JackToaster/SynthPass/hardware/SynthPass.kicad_pcb

## KiCad design hardware/SynthPass.kicad_pcb (2026-10-18)

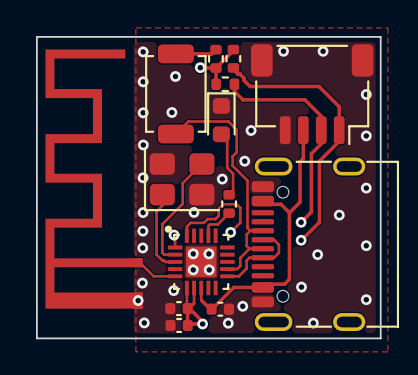
[picture p1: board SynthPass.kicad_pcb from above]

Board: 4 copper layers, 19.1 x 16.8 mm, 14 parts (0 on the bottom side), 13 nets.

Parts:
AE1: PCB Antenna; Texas_SWRA117D_2.4GHz_Right
C1, C3: 10u; C_0402_1005Metric
C4: 0.1u; C_0402_1005Metric
D1: LED_Small; LED_0603_1608Metric
J1: SM04B-SRSS-TB; JST_SH_SM04B-SRSS-TB_1x04-1MP_P1.00mm_Horizontal
P1: USB_C_Plug_USB2.0; USB_C_Receptacle_G-Switch_GT-USB-7010ASV
R1, R2, R3, R4: 5.1k; R_0402_1005Metric
SW1: SW_Push; SW_SPST_TS-1088-xR020
U2: CH572D
Y2: 32MHz; Crystal_SMD_3225-4Pin_3.2x2.5mm

Connections:
+3V3: C3.1, C4.1, R1.2, R3.2, R4.2, U2.6 (VDD33), U2.7 (VIO33)
GND: AE1.2 (PCB_Trace), C1.2, C3.2, C4.2, D1.1 (K), J1.4, J1.MP (MountPin), P1.A1 (GND), P1.A12 (GND), P1.B1 (GND), P1.B12 (GND), U2.21 (GND/EPAD), Y2.2, Y2.4
unnamed: AE1.1 (FEED), U2.5 (ANT)
unnamed: D1.2 (A), R2.2
unnamed: R1.1, SW1.2
unnamed: R2.1, U2.17 (PA10/R6/T7)
unnamed: U2.3 (XI), Y2.1
unnamed: U2.2 (XO), Y2.3
SCL: J1.1, R3.1, U2.1 (PA3/T/R1/SCL2/SCK_/PWM3/CP0)
SDA: J1.2, R4.1, U2.20 (PA2/R/T1/SDA2/SCS_/PWM2/TMR1/CN)
UDM: P1.A7 (D-), P1.B7 (D-), U2.11 (PA0/UDM/R2/T3/SCL1)
UDP: P1.A6 (D+), P1.B6 (D+), SW1.1, U2.12 (PA1/UDP/R3/T2/SDA1)
VBUS: C1.1, J1.3, P1.A4 (VBUS), P1.A9 (VBUS), P1.B4 (VBUS), P1.B9 (VBUS), U2.8 (V5)
