JackToaster/SynthPass/(commit log)

2026-02-08 Add WireShark plugin for dissecting synthpass packets
2026-05-27 File storage change - single MD stream for messages + separate storage for attachment files
2026-05-28 Message store cleanup and bugfixes
    [msgstore.c, msgstore.h, radio.c, usb.c]
2026-06-27 Add config, fix USB MSC issues, boop transfers data
    [SynthPass.c, board.h, config.c, config.h, msgstore.c, msgstore.h, radio.c, synthpass.h]
2026-08-10 fix the fix for the bootloader fix
    [SynthPass.c, radio.c, radio.h]
2026-10-18 v2 schematic changes pending review
